mossblaser/wordClockie/software/word_clock/eyes_0_.png.h

prog_uchar eyes_0_[2*14] PROGMEM = {
	0x00, 0x00, 
	0x18, 0x0C, 
	0x24, 0x12, 
	0x24, 0x12, 
	0x18, 0x0C, 
	0x00, 0x00, 
	0x00, 0x00, 
	0x00, 0x00, 
	0x00, 0x00, 
	0x00, 0x00, 
	0x00, 0x00, 
	0x00, 0x00, 
	0x00, 0x00, 
	0x00, 0x00, 
};
