mossblaser/wordClockie/software/word_clock/eyes_1.png.h

prog_uchar eyes_1[2*14] PROGMEM = {
	0x00, 0x00, 
	0x18, 0x0C, 
	0x3C, 0x1E, 
	0x00, 0x00, 
	0x00, 0x00, 
	0x00, 0x00, 
	0x00, 0x00, 
	0x00, 0x00, 
	0x00, 0x00, 
	0x00, 0x00, 
	0x00, 0x00, 
	0x00, 0x00, 
	0x00, 0x00, 
	0x00, 0x00, 
};
