mossblaser/wordClockie/software/word_clock/eyes_n2.png.h

prog_uchar eyes_n2[2*14] PROGMEM = {
	0x00, 0x00, 
	0x00, 0x00, 
	0x30, 0x06, 
	0x18, 0x0C, 
	0x0C, 0x18, 
	0x00, 0x00, 
	0x00, 0x00, 
	0x00, 0x00, 
	0x00, 0x00, 
	0x00, 0x00, 
	0x00, 0x00, 
	0x00, 0x00, 
	0x00, 0x00, 
	0x00, 0x00, 
};
