mossblaser/wordClockie/software/word_clock/mouth_0.png.h

prog_uchar mouth_0[2*14] PROGMEM = {
	0x00, 0x00, 
	0x00, 0x00, 
	0x00, 0x00, 
	0x00, 0x00, 
	0x00, 0x00, 
	0x00, 0x00, 
	0x00, 0x00, 
	0x00, 0x00, 
	0x00, 0x00, 
	0x00, 0x00, 
	0xF8, 0x0F, 
	0x00, 0x00, 
	0x00, 0x00, 
	0x00, 0x00, 
};
