mossblaser/wordClockie/software/word_clock/mouth_1.png.h

prog_uchar mouth_1[2*14] PROGMEM = {
	0x00, 0x00, 
	0x00, 0x00, 
	0x00, 0x00, 
	0x00, 0x00, 
	0x00, 0x00, 
	0x00, 0x00, 
	0x00, 0x00, 
	0x00, 0x00, 
	0x00, 0x00, 
	0x08, 0x08, 
	0xF8, 0x0F, 
	0x00, 0x00, 
	0x00, 0x00, 
	0x00, 0x00, 
};
