mossblaser/wordClockie/software/word_clock/mouth_10.png.h

prog_uchar mouth_10[2*14] PROGMEM = {
	0x00, 0x00, 
	0x00, 0x00, 
	0x00, 0x00, 
	0x00, 0x00, 
	0x00, 0x00, 
	0x00, 0x00, 
	0x00, 0x00, 
	0x02, 0x20, 
	0x0C, 0x18, 
	0xFC, 0x1F, 
	0xF8, 0x0F, 
	0xF0, 0x07, 
	0xE0, 0x03, 
	0x80, 0x00, 
};
