mossblaser/wordClockie/software/word_clock/mouth_11.png.h

prog_uchar mouth_11[2*14] PROGMEM = {
	0x00, 0x00, 
	0x00, 0x00, 
	0x00, 0x00, 
	0x00, 0x00, 
	0x00, 0x00, 
	0x00, 0x00, 
	0x00, 0x00, 
	0x02, 0x20, 
	0x0E, 0x38, 
	0xFE, 0x3F, 
	0xFC, 0x1F, 
	0xF8, 0x0F, 
	0xF0, 0x07, 
	0xE0, 0x03, 
};
