mossblaser/wordClockie/software/word_clock/mouth_15.png.h

prog_uchar mouth_15[2*14] PROGMEM = {
	0x00, 0x00, 
	0x00, 0x00, 
	0x00, 0x00, 
	0x00, 0x00, 
	0x00, 0x00, 
	0x00, 0x00, 
	0x02, 0x20, 
	0x06, 0x30, 
	0x1E, 0x3C, 
	0xFE, 0x3F, 
	0xFC, 0x1F, 
	0xFC, 0x1F, 
	0xFC, 0x1F, 
	0xF8, 0x0F, 
};
