mossblaser/wordClockie/software/word_clock/mouth_3.png.h

prog_uchar mouth_3[2*14] PROGMEM = {
	0x00, 0x00, 
	0x00, 0x00, 
	0x00, 0x00, 
	0x00, 0x00, 
	0x00, 0x00, 
	0x00, 0x00, 
	0x00, 0x00, 
	0x00, 0x00, 
	0x00, 0x00, 
	0x08, 0x08, 
	0x70, 0x07, 
	0x80, 0x00, 
	0x00, 0x00, 
	0x00, 0x00, 
};
