mossblaser/wordClockie/software/word_clock/mouth_4.png.h

prog_uchar mouth_4[2*14] PROGMEM = {
	0x00, 0x00, 
	0x00, 0x00, 
	0x00, 0x00, 
	0x00, 0x00, 
	0x00, 0x00, 
	0x00, 0x00, 
	0x00, 0x00, 
	0x00, 0x00, 
	0x04, 0x10, 
	0x08, 0x08, 
	0x70, 0x07, 
	0x80, 0x00, 
	0x00, 0x00, 
	0x00, 0x00, 
};
