mossblaser/wordClockie/software/word_clock/mouth_6.png.h

prog_uchar mouth_6[2*14] PROGMEM = {
	0x00, 0x00, 
	0x00, 0x00, 
	0x00, 0x00, 
	0x00, 0x00, 
	0x00, 0x00, 
	0x00, 0x00, 
	0x00, 0x00, 
	0x04, 0x10, 
	0x04, 0x10, 
	0x08, 0x08, 
	0x30, 0x06, 
	0xC0, 0x01, 
	0x00, 0x00, 
	0x00, 0x00, 
};
