mossblaser/wordClockie/software/word_clock/mouth_8.png.h

prog_uchar mouth_8[2*14] PROGMEM = {
	0x00, 0x00, 
	0x00, 0x00, 
	0x00, 0x00, 
	0x00, 0x00, 
	0x00, 0x00, 
	0x00, 0x00, 
	0x00, 0x00, 
	0x06, 0x30, 
	0x04, 0x10, 
	0x18, 0x0C, 
	0xF0, 0x07, 
	0xE0, 0x03, 
	0xC0, 0x01, 
	0x00, 0x00, 
};
