mossblaser/wordClockie/software/word_clock/mouth_9.png.h

prog_uchar mouth_9[2*14] PROGMEM = {
	0x00, 0x00, 
	0x00, 0x00, 
	0x00, 0x00, 
	0x00, 0x00, 
	0x00, 0x00, 
	0x00, 0x00, 
	0x00, 0x00, 
	0x02, 0x20, 
	0x0C, 0x18, 
	0xF8, 0x0F, 
	0xF0, 0x07, 
	0xF0, 0x07, 
	0xC0, 0x01, 
	0x80, 0x00, 
};
