mossblaser/wordClockie/software/word_clock/mouth_n2.png.h

prog_uchar mouth_n2[2*14] PROGMEM = {
	0x00, 0x00, 
	0x00, 0x00, 
	0x00, 0x00, 
	0x00, 0x00, 
	0x00, 0x00, 
	0x00, 0x00, 
	0x00, 0x00, 
	0x00, 0x00, 
	0x00, 0x00, 
	0x00, 0x00, 
	0xF0, 0x07, 
	0x08, 0x08, 
	0x00, 0x00, 
	0x00, 0x00, 
};
