mossblaser/wordClockie/software/word_clock/mouth_n3.png.h

prog_uchar mouth_n3[2*14] PROGMEM = {
	0x00, 0x00, 
	0x00, 0x00, 
	0x00, 0x00, 
	0x00, 0x00, 
	0x00, 0x00, 
	0x00, 0x00, 
	0x00, 0x00, 
	0x00, 0x00, 
	0x00, 0x00, 
	0x80, 0x00, 
	0x70, 0x07, 
	0x08, 0x08, 
	0x00, 0x00, 
	0x00, 0x00, 
};
