mossblaser/wordClockie/(commit log)

2014-12-18 Initial functioning clock firmware.
    Features:
    * Displays message on startup
    * Displays the time (currently with iffy grammar ("its" ))
    * Can be updated via Unicom (but does not inform the user that this is taking
    place or going well.
    * Does not display marriage time...
2014-12-22 Select a more ledgible font.
2014-12-23 Added general resources.
    [assembly.scad, back.scad, face.scad]
